DoubleDoo/PLUMPY-CW2023/README.md

# PLUMPY-CW2023
Hardware-software Complex for Human Movement Data Tracking and Analyzing 2023 Group Project
