DoubleDoo/PLUMPY-CW2023/DeviceApp/README.md

# ПО аппаратной части программно-аппаратного комлпекса Рывок-1

Данный репозиторий сожержит проекты для IDE STM32CubeProgrammer 2.13.0

С использованием библиотеки STM32Cube_FW_WB_V1.16.0

## BOARD_APP

Финальная версия ПО для устройства

## BOARD_TESTS

Собранные прошивки для проверки работоспособности прототипов и готовых устройств

## Статус проекта
В данный момент идет дальнейшее тестирование прототипов и написание кода для устройства
