DoubleDoo/PLUMPY-CW2023/DevicePCB/README.md

# Печатная плата программно-аппаратного комлпекса Рывок-1

Данный репозиторий сожержит проекты для САПР Altium Designer 23 23.0.1.38

## LEGACY

Исследовательские версии печатной платы, созданная перед версией для отладки

## FINAL_BOARD

Улучшенная печатная плата с исправлением ошибок, созданная на основании тестирования отладочной версии.

## Статус проекта
В данный момент идет дальнейшее тестирование прототипа.
