DoubleDoo/PLUMPY-CW2023/DeviceCase/README.md

# Корпус для отладочной аппаратной части программно-аппаратного комлпекса Рывок-1

Данная папка сожержит файлы для САПР КОМПАС-3D v21

## Корпус

Основа корпуса, удерживающая плату

## Крышка

Крышка закрывающа плату от доступа из вне

## Clock

Крышка и корпус в сборке

## Статус проекта
В данный момент работа над корпусом для отладочной платы завершена
