DoubleDoo/PLUMPY-CW2023/DeviceCase/Корпус.stl

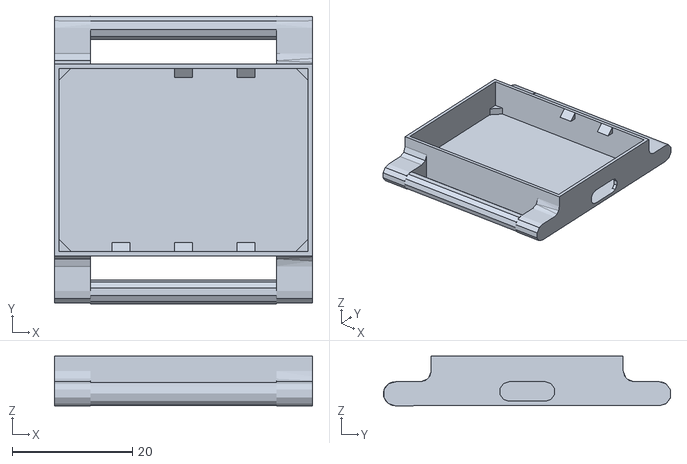
[picture p44: CAD file, 2023-06-03]
DeviceCase/Корпус.stl
43.0 x 47.9 x 8.25
