DoubleDoo/PLUMPY-CW2023/DeviceCase/Kрышка.stl

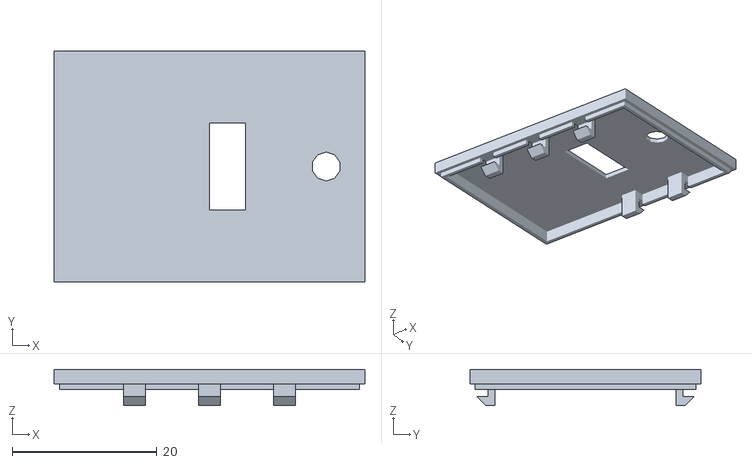
[picture p45: CAD file, 2023-06-03]
DeviceCase/Kрышка.stl
43.0 x 32.0 x 5.00
