DoubleDoo/PLUMPY-CW2023/(list of files, drawings)

Other design files:
DevicePCB/FINAL_BOARD/Custom..SchLib
DevicePCB/FINAL_BOARD/Custom.PcbLib
DevicePCB/FINAL_BOARD/Device.PcbDoc
DevicePCB/FINAL_BOARD/Device.SchDoc
DevicePCB/FINAL_BOARD/FINAL_BOARD.PrjPcb
DevicePCB/FINAL_BOARD/L6924D013TR.SchDoc
DevicePCB/FINAL_BOARD/LPS22HBTR.SchDoc
DevicePCB/FINAL_BOARD/LSM6DSRXTR.SchDoc
DevicePCB/FINAL_BOARD/M24512-DFMC6TG.SchDoc
DevicePCB/FINAL_BOARD/ReadyButNotListed.PcbLib
DevicePCB/FINAL_BOARD/ReadyButNotListed.SchLib
DevicePCB/FINAL_BOARD/ST25DV64K-JFR6D3.SchDoc
DevicePCB/FINAL_BOARD/STM32WB55CGU6.SchDoc
DevicePCB/FINAL_BOARD/SWD.SchDoc
DevicePCB/FINAL_BOARD/USB.SchDoc
DevicePCB/FINAL_BOARD/VIBRO.SchDoc
DevicePCB/LEGACY/ver1/ANT.PcbLib
DevicePCB/LEGACY/ver1/ANT.SchLib
DevicePCB/LEGACY/ver1/Device.SchDoc
DevicePCB/LEGACY/ver1/Diplom_project.PrjPcb
DevicePCB/LEGACY/ver1/L6924D013TR.SchDoc
DevicePCB/LEGACY/ver1/LD3985M33R.SchDoc
DevicePCB/LEGACY/ver1/LPS22HBTR.SchDoc
DevicePCB/LEGACY/ver1/LSM6DSRXTR.SchDoc
DevicePCB/LEGACY/ver1/M24512-DFMC6TG.SchDoc
DevicePCB/LEGACY/ver1/PCB.PcbDoc
DevicePCB/LEGACY/ver1/PcbLib.PcbLib
DevicePCB/LEGACY/ver1/ST25DV64K-JFR6D3.SchDoc
DevicePCB/LEGACY/ver1/STM32WB55CGU6.SchDoc
DevicePCB/LEGACY/ver1/SWD.SchDoc
DevicePCB/LEGACY/ver1/USB.SchDoc
DevicePCB/LEGACY/ver1/VIBRO.SchDoc
DevicePCB/LEGACY/Ver2/ANT.PcbLib
DevicePCB/LEGACY/Ver2/ANT.SchLib
DevicePCB/LEGACY/Ver2/Device.SchDoc
DevicePCB/LEGACY/Ver2/L6924D013TR.SchDoc
DevicePCB/LEGACY/Ver2/LD3985M33R.SchDoc
DevicePCB/LEGACY/Ver2/LPS22HBTR.SchDoc
DevicePCB/LEGACY/Ver2/LSM6DSRXTR.SchDoc
DevicePCB/LEGACY/Ver2/M24512-DFMC6TG.SchDoc
DevicePCB/LEGACY/Ver2/PCB.PcbDoc
DevicePCB/LEGACY/Ver2/PcbLib.PcbLib
DevicePCB/LEGACY/Ver2/ST25DV64K-JFR6D3.SchDoc
DevicePCB/LEGACY/Ver2/STM32WB55CGU6.SchDoc
DevicePCB/LEGACY/Ver2/SWD.SchDoc
DevicePCB/LEGACY/Ver2/USB.SchDoc
DevicePCB/LEGACY/Ver2/Ver2.PrjPcb
DevicePCB/LEGACY/Ver2/VIBRO.SchDoc
DevicePCB/LEGACY/Ver3/ANT.PcbLib
DevicePCB/LEGACY/Ver3/ANT.SchLib
DevicePCB/LEGACY/Ver3/L6924D013TR.SchDoc
DevicePCB/LEGACY/Ver3/LD3985M33R.SchDoc
DevicePCB/LEGACY/Ver3/LPS22HBTR.SchDoc
DevicePCB/LEGACY/Ver3/LSM6DSRXTR.SchDoc
DevicePCB/LEGACY/Ver3/M24512-DFMC6TG.SchDoc
DevicePCB/LEGACY/Ver3/PcbLib.PcbLib
DevicePCB/LEGACY/Ver3/Power.PcbDoc
DevicePCB/LEGACY/Ver3/Power.SchDoc
DevicePCB/LEGACY/Ver3/ST25DV64K-JFR6D3.SchDoc
DevicePCB/LEGACY/Ver3/STM32WB55CGU6.SchDoc
DevicePCB/LEGACY/Ver3/SWD.SchDoc
DevicePCB/LEGACY/Ver3/USB.SchDoc
DevicePCB/LEGACY/Ver3/Ver3.PrjPcb
DevicePCB/LEGACY/Ver3/VIBRO.SchDoc
DevicePCB/LEGACY/ver4/Custom..SchLib
DevicePCB/LEGACY/ver4/Custom.PcbLib
DevicePCB/LEGACY/ver4/DEV_BOARD.PrjPcb
DevicePCB/LEGACY/ver4/Device.PcbDoc
DevicePCB/LEGACY/ver4/Device.SchDoc
DevicePCB/LEGACY/ver4/L6924D013TR.SchDoc
DevicePCB/LEGACY/ver4/LPS22HBTR.SchDoc
DevicePCB/LEGACY/ver4/LSM6DSRXTR.SchDoc
DevicePCB/LEGACY/ver4/M24512-DFMC6TG.SchDoc
DevicePCB/LEGACY/ver4/ReadyButNotListed.PcbLib
DevicePCB/LEGACY/ver4/ReadyButNotListed.SchLib
DevicePCB/LEGACY/ver4/ST25DV64K-JFR6D3.SchDoc
DevicePCB/LEGACY/ver4/STM32WB55CGU6.SchDoc
DevicePCB/LEGACY/ver4/SWD.SchDoc
DevicePCB/LEGACY/ver4/USB.SchDoc
DevicePCB/LEGACY/ver4/VIBRO.SchDoc
DevicePCB/UPDATE/Custom..SchLib
DevicePCB/UPDATE/Custom.PcbLib
DevicePCB/UPDATE/Device.PcbDoc
DevicePCB/UPDATE/Device.SchDoc
DevicePCB/UPDATE/L6924D013TR.SchDoc
DevicePCB/UPDATE/LD3985M33R.SchDoc
DevicePCB/UPDATE/LPS22HBTR.SchDoc
DevicePCB/UPDATE/LSM6DSRXTR.SchDoc
DevicePCB/UPDATE/M24512-DFMC6TG.SchDoc
DevicePCB/UPDATE/PCBVer2.PcbDoc
DevicePCB/UPDATE/PCBVer3.PcbDoc
DevicePCB/UPDATE/PCBVer4.PcbDoc
DevicePCB/UPDATE/ReadyButNotListed.PcbLib
DevicePCB/UPDATE/ReadyButNotListed.SchLib
DevicePCB/UPDATE/STM32WB55CGU6.SchDoc
DevicePCB/UPDATE/SWD.SchDoc
DevicePCB/UPDATE/TC58BVG1S3HBAI4.SchDoc
DevicePCB/UPDATE/UPDATE.PrjPcb
DevicePCB/UPDATE/USB.SchDoc
DevicePCB/UPDATE/VIBRO.SchDoc
