DoubleDoo/PLUMPY-CW2023/DeviceApp/BOARD_APP/DEV_BOARD_APP.ioc

Mcu.UserName=STM32WB55CGUx
PA0.Signal=GPIO_Output
PA1.Signal=GPIO_Input
PA3.Signal=GPXTI3
PA4.Signal=GPIO_Input
PB2.Signal=GPIO_Output
PB6.Signal=I2C1_SCL
PB7.Signal=I2C1_SDA
PC14-OSC32_IN.Signal=RCC_OSC32_IN
PC15-OSC32_OUT.Signal=RCC_OSC32_OUT
