DoubleDoo/PLUMPY-CW2023/(commit log)

2023-06-05 add Android App
    [app_bar_general.xml]
2024-04-28 first update version
    [Custom..SchLib, Custom.PcbLib, Device.PcbDoc, Device.SchDoc, L6924D013TR.SchDoc, LD3985M33R.SchDoc, LPS22HBTR.SchDoc, LSM6DSRXTR.SchDoc]
2024-04-29 new version
    [Custom..SchLib, Custom.PcbLib, Device.SchDoc, L6924D013TR.SchDoc, LD3985M33R.SchDoc, LPS22HBTR.SchDoc, LSM6DSRXTR.SchDoc, M24512-DFMC6TG.SchDoc]
