DoubleDoo/PLUMPY-CW2023/(notices)

Notices in the files:
DeviceApp/BOARD_APP/STM32_WPAN/App/custom_app.c:
Copyright (c) 2023 STMicroelectronics.
All rights reserved.
This software is licensed under terms that can be found in the LICENSE file
